jnsbyr/attiny-projection-screen-trigger/(commit log)

2021-01-06 power saving while monitoring analog inputs
2021-01-06 support extended startup delay with power saving
2021-03-13 repurpose pin 5 to report the trigger state to control HDMI switch
