jnsbyr/attiny-projection-screen-trigger/(notices)

Notices in the files:
README.md:
License: CC BY-NC-SA 4.0
License: Apache 2.0
License: LGPL v2.1
License: GPL v3.1
